xelalexv/spectratur/doc/breadboard.jpg

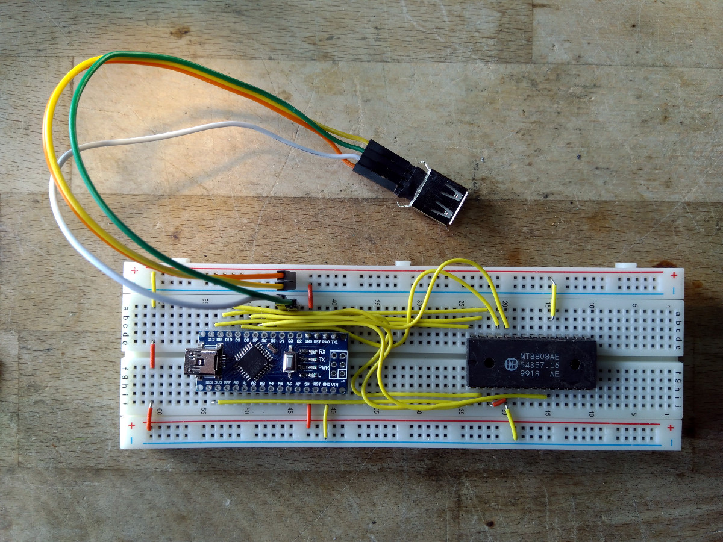
doc/breadboard.jpg
