xelalexv/spectratur/(threads)

Thread 1 (2020-10-20):

Support for MT8812 & 8816

xelalexv, 2020-10-20:
The MT8812 and 8816 offer 8x12 and 8x16 switch matrices, respectively, and would be an option for larger target keyboards. Target key addresses would need to use 7 bits instead of the current 6 bits (one additional bit for `AX3`). Combo marker bit in target key codes needs to be shifted to bit 7 from bit 6. On an *Arduino Nano* with USB keyboard and joystick port fitted, we would only have pins `D2` and `C5` left for connecting to `AX3`. I'd prefer `C5` since `D2` is interrupt capable and might have some other use later on.

xelalexv, 2020-10-21:
A first implementation is now in branch `mt88xx`. Works fine with the MT8808 in my _Spectrum_, but I have no way of testing with an MT8812 or 16. I'll do a bit more testing, and then merge.

xelalexv, 2020-10-22:
Did a few more tests with my MT8808 setup, and found & fixed a problem with joystick setup, which was actually not related to this change at all. Otherwise seems fine.

Closed 2020-10-22.
