xelalexv/spectratur/(commit log)

2020-10-20 [doc] added MT8808 pin labels to schematic
2020-10-22 issue #1: support for MT8812/16
    [config.h, keymap.cpp, mt88xx.cpp, mt88xx.h, serialkbd.cpp, spectratur.ino, target_spectrum.h, targetkbd.cpp]
2020-10-22 issue #1: fixed joystick setup; improved log messages
    [externalkbd.cpp, joystick.cpp, targetkbd.cpp]
2021-01-07 corrected up & down cursor keys
    [target_spectrum.h]
2021-02-15 [kev] filter out auto-repeated keys
